RevFur/PurrEngine-hardware/Mechanical/Head_Transducer/Printable/Main_Body.stl

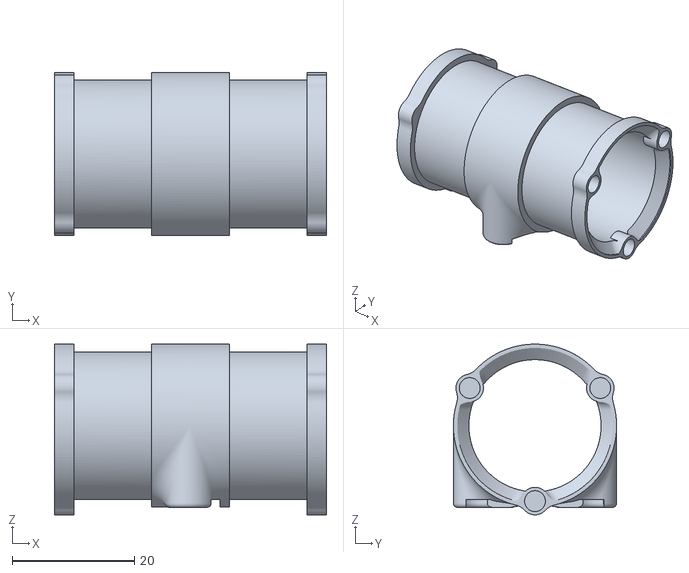
[picture p1: CAD file, 2018-11-15]
Mechanical/Head_Transducer/Printable/Main_Body.stl
44.5 x 26.7 x 27.9
