RevFur/PurrEngine-hardware/Mechanical/Chest_Transducer/Chest_Harness.step

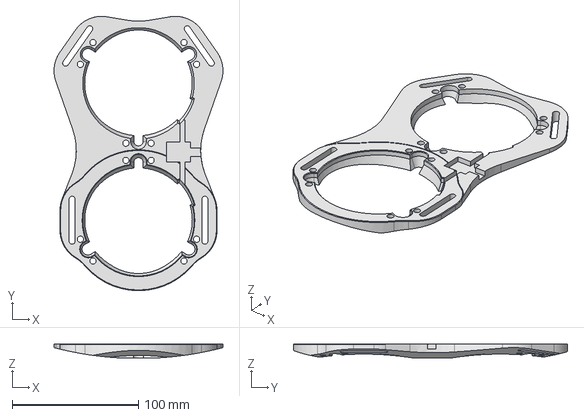
[picture p2: CAD file, 2018-11-15]
Mechanical/Chest_Transducer/Chest_Harness.step
134.1 x 217.6 x 11.2 mm
