RevFur/PurrEngine-hardware/Mechanical/Chest_Transducer/Dayton_Audio_Transducer.step

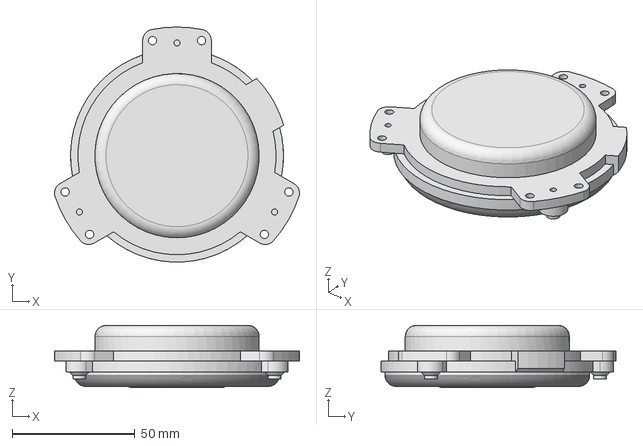
[picture p3: CAD file, 2018-11-15]
Mechanical/Chest_Transducer/Dayton_Audio_Transducer.step
100.0 x 95.9 x 25.4 mm
