RevFur/PurrEngine-hardware/Mechanical/Head_Transducer/Printable/Flexure.stl

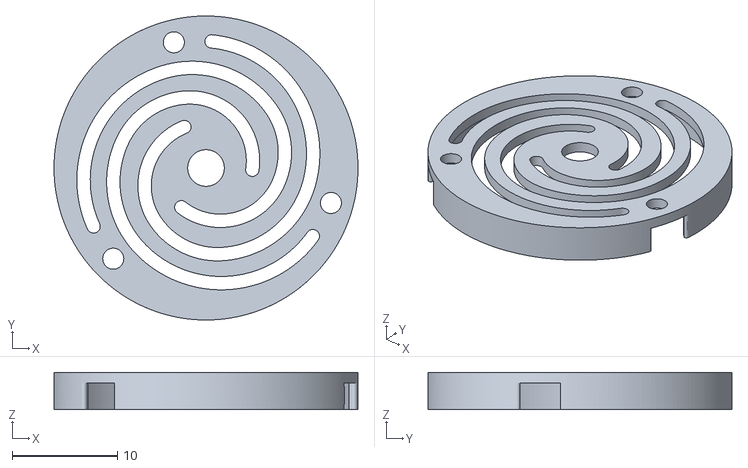
[picture p4: CAD file, 2018-11-15]
Mechanical/Head_Transducer/Printable/Flexure.stl
28.9 x 28.9 x 3.56
