RevFur/PurrEngine-hardware/Mechanical/Head_Transducer/Printable/Pin_Clip.stl

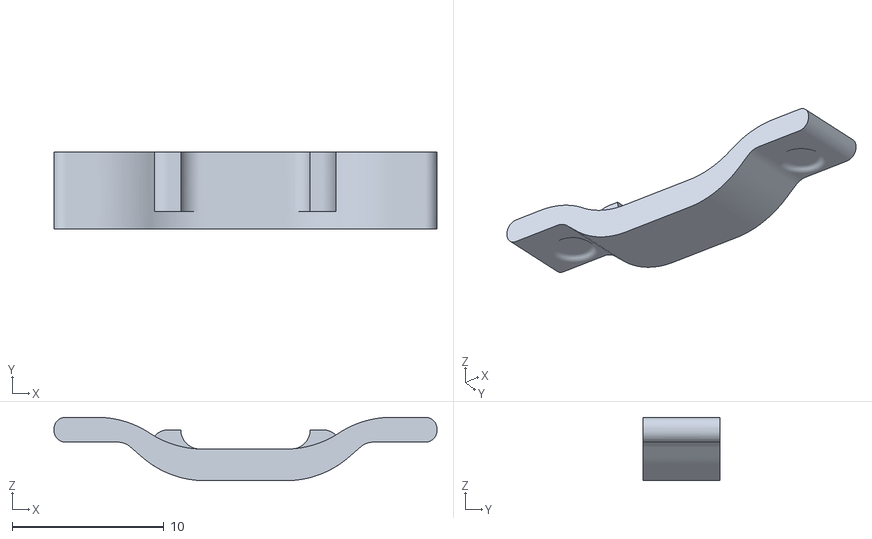
[picture p5: CAD file, 2018-11-15]
Mechanical/Head_Transducer/Printable/Pin_Clip.stl
25.2 x 5.08 x 4.18
