RevFur/PurrEngine-hardware/Mechanical/Head_Transducer/Printable/Spacer_0p125.stl

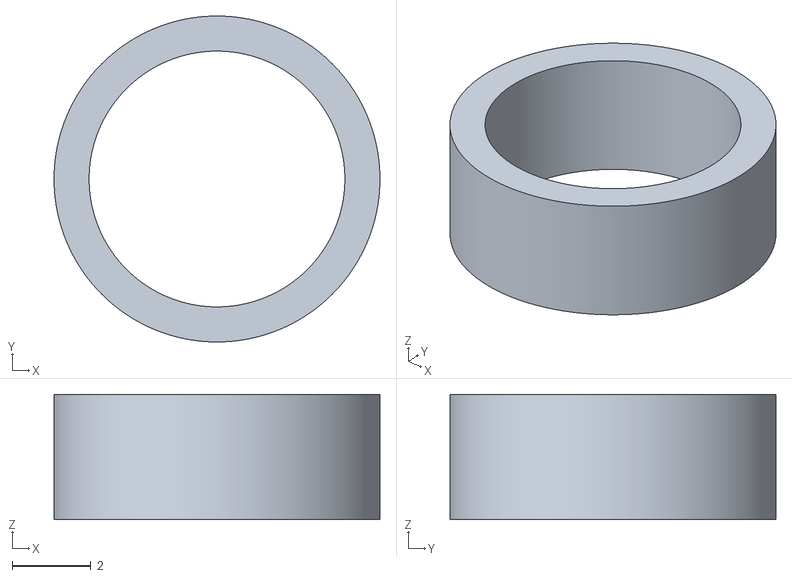
[picture p6: CAD file, 2018-11-15]
Mechanical/Head_Transducer/Printable/Spacer_0p125.stl
8.26 x 8.26 x 3.17
