RevFur/PurrEngine-hardware/Mechanical/Head_Transducer/Printable/Saddle.stl

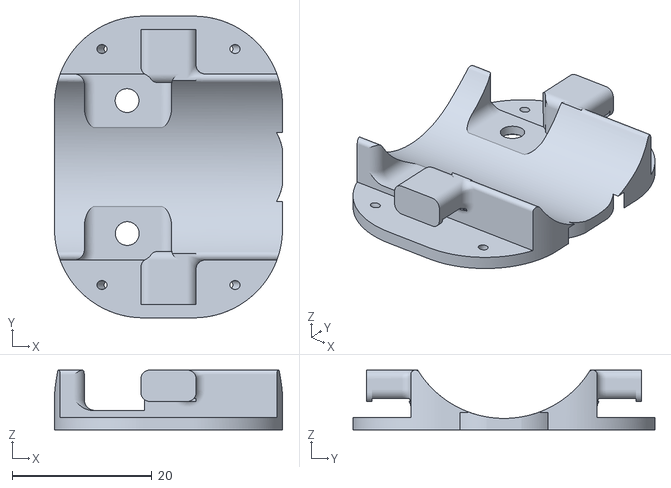
[picture p7: CAD file, 2018-11-15]
Mechanical/Head_Transducer/Printable/Saddle.stl
32.6 x 43.2 x 8.58
