RevFur/PurrEngine-hardware/(list of files, cad)

Other CAD files:
Mechanical/Chest_Transducer/Printable/Chest_Harness.stl
