RevFur/PurrEngine-hardware/PCB/Drawings/Purr_Amp.pdf

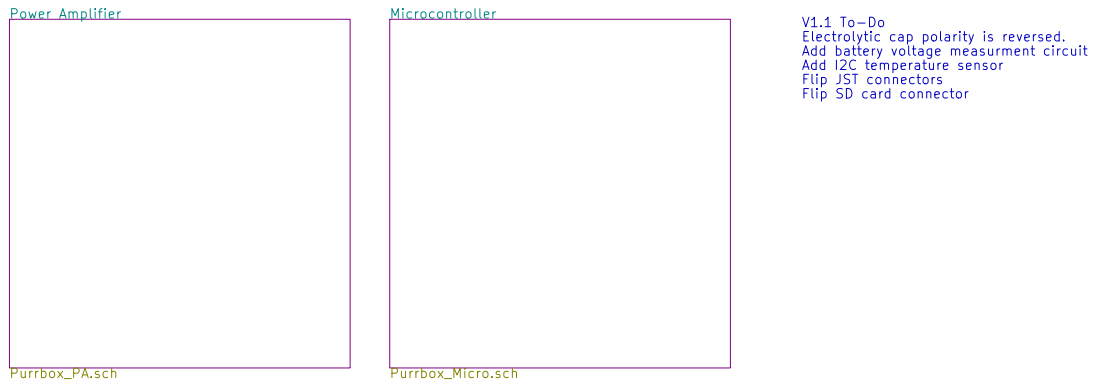
[picture p8: page 1]

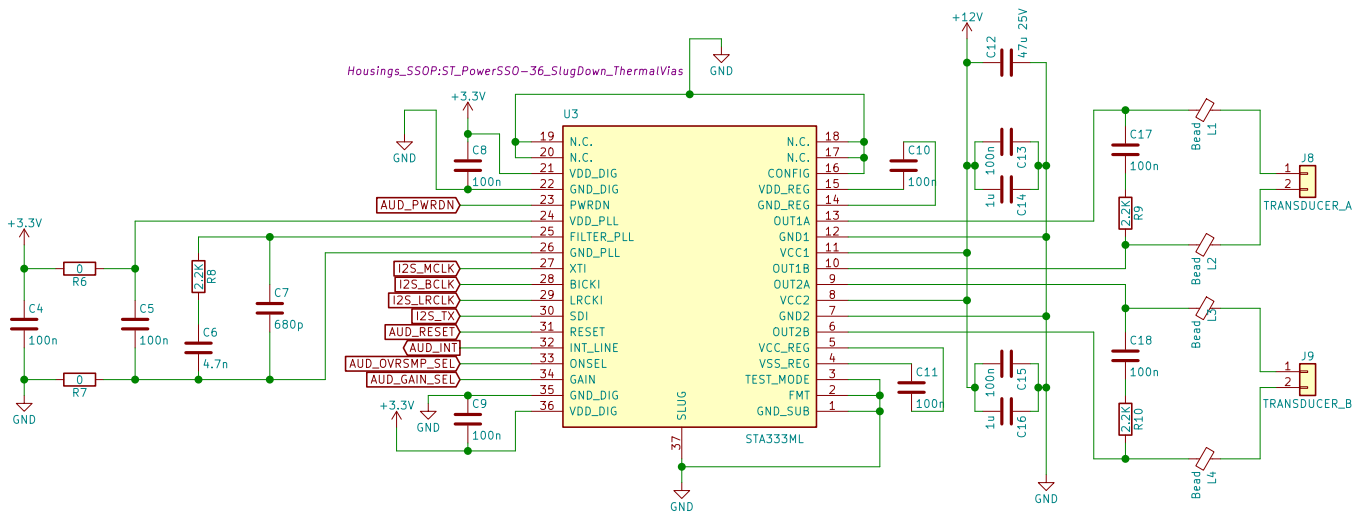
[picture p9: page 2]

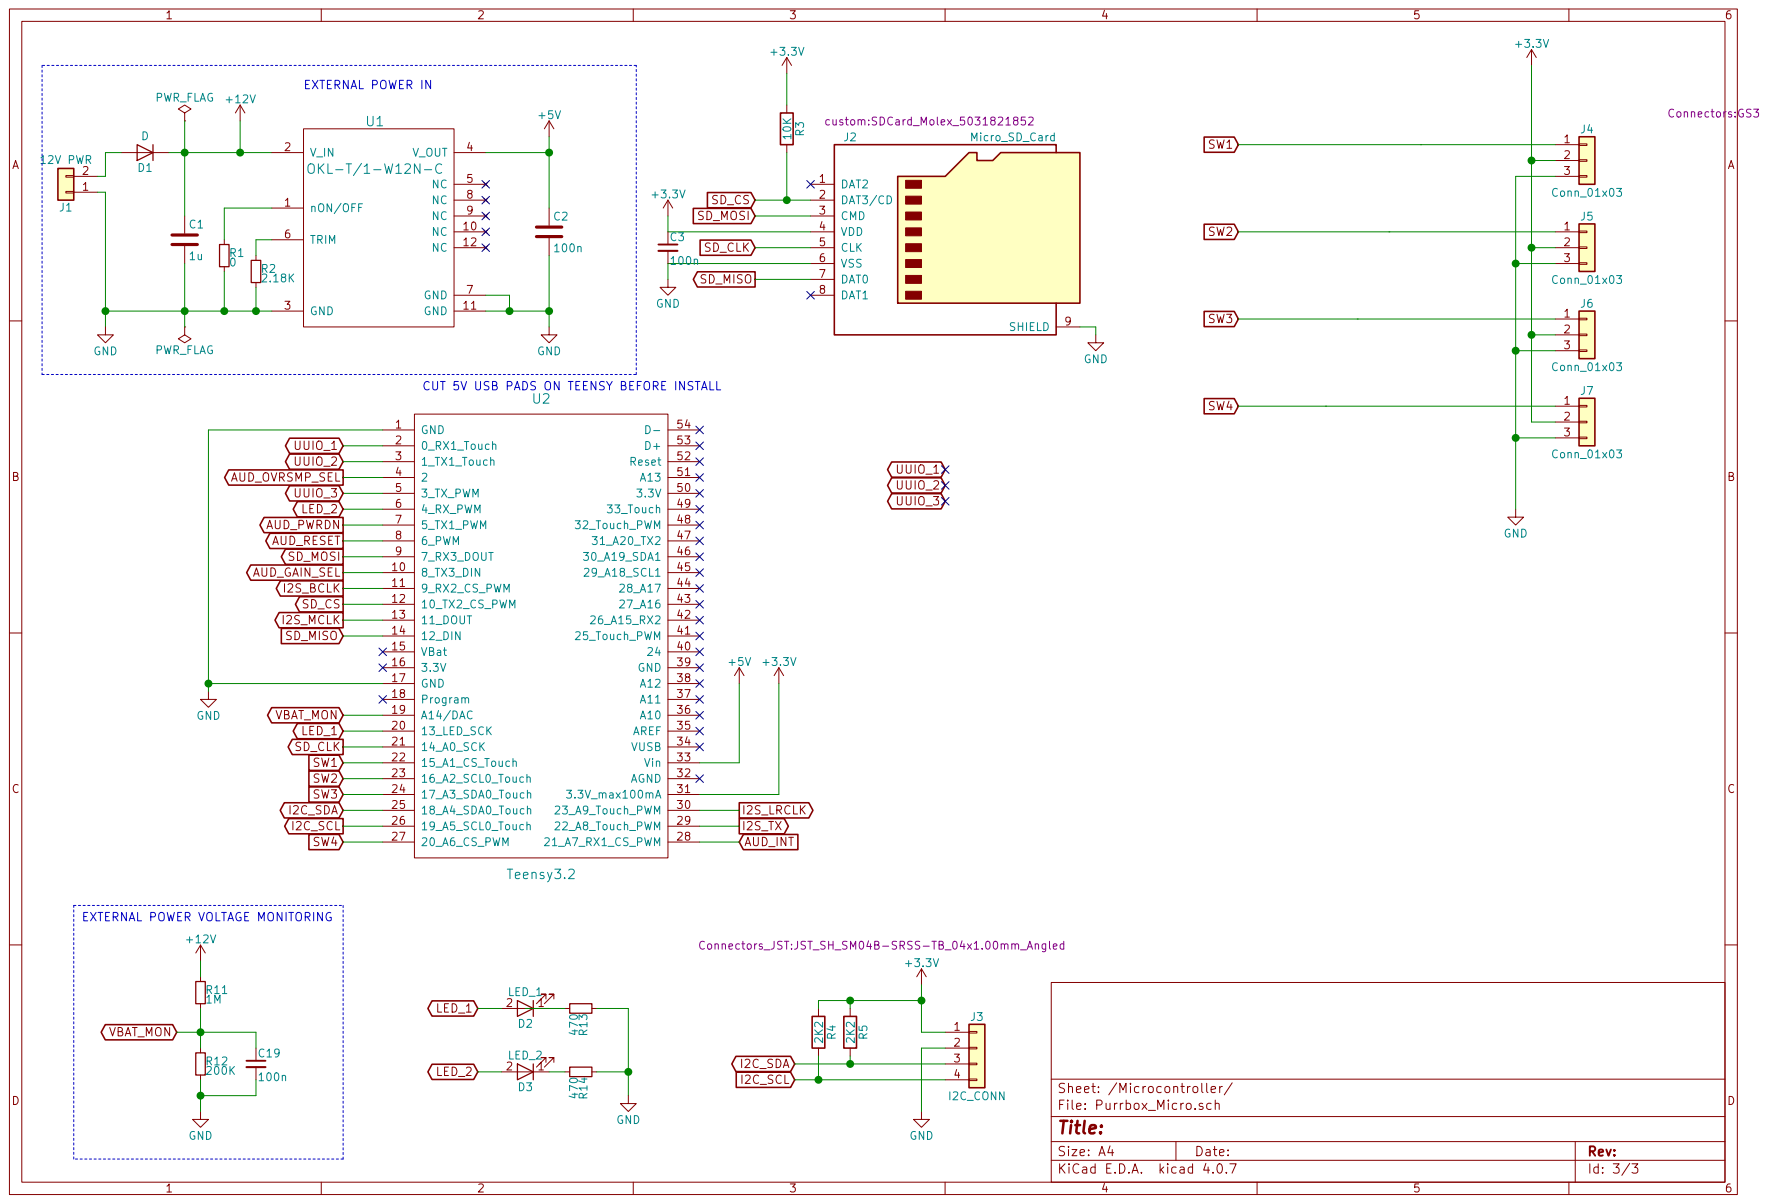
[picture p10: page 3]
