RevFur/PurrEngine-hardware/PCB/Purr_Amp.kicad_pcb

## KiCad design PCB/Purr_Amp.kicad_pcb (2018-11-15)

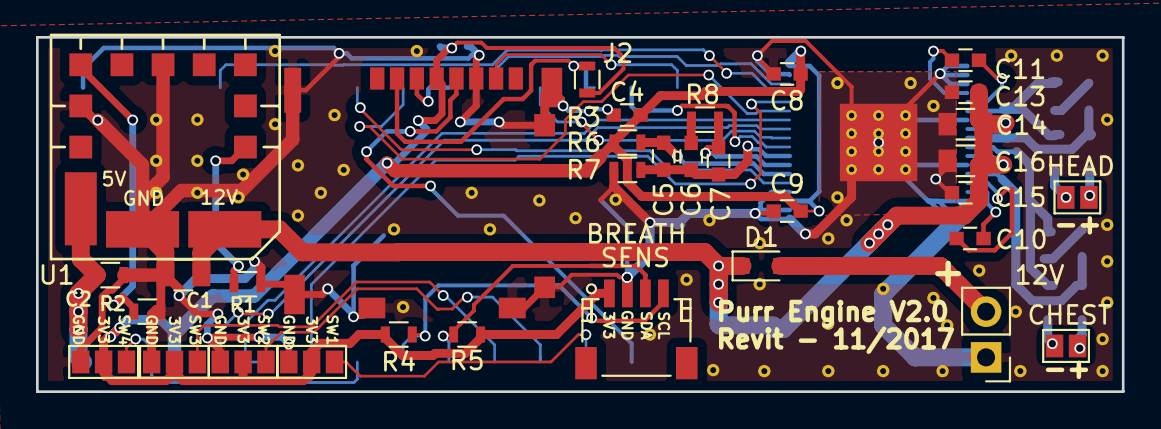
[picture p11: board Purr_Amp.kicad_pcb from above]

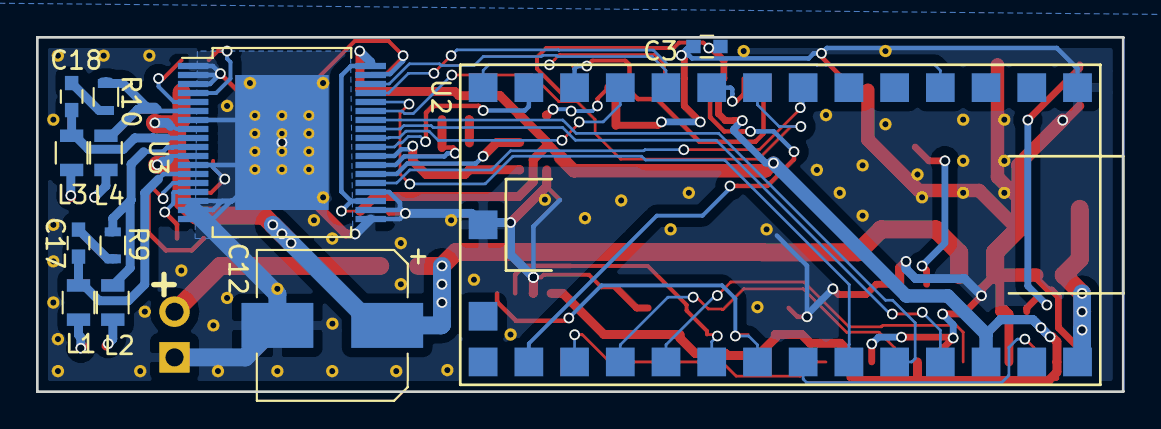
[picture p12: board Purr_Amp.kicad_pcb from below]

Board: 2 copper layers, 60.3 x 19.7 mm, 45 parts (12 on the bottom side), 44 nets.

Parts:
12V: 12V PWR; Pin_Header_Straight_1x02_Pitch2.54mm
BREATH: I2C_CONN; JST_SH_SM04B-SRSS-TB_04x1.00mm_Angled
C1: .33u; C_0805
C2: 100n; R_0603
C3, C4, C5, C8, C9, C10, C11, C13, C15, C17, C18: 100n; C_0603
C6: 4.7n; C_0603
C7: 680p; C_0603
C12: 47u 25V; CP_Elec_8x6.7
C14, C16: 1u; C_0805
CHEST: TRANSDUCER_A; GS2
D1: D; D_0805
HEAD: TRANSDUCER_B; GS2
J2: Micro_SD_Card; SDCard_Molex_5031821852
J4, J5, J6, J7: Conn_01x03; GS3
L1, L2, L3, L4: Bead; R_0805
R1, R6, R7: 0; R_0603
R2: 2.18K; R_0603
R3: 10K; R_0603
R4, R5: 2K2; R_0603
R8, R9, R10: 2.2K; R_0603
U1: OKL-T/1-W12N-C; MURATA_OKL1
U2: Teensy3.2; Teensy3.4_SMD
U3: STA333ML; ST_PowerSSO-36_SlugDown_ThermalVias

Connections:
+3V3: BREATH.1, C3.1, C4.1, C8.1, C9.2, J2.4, J4.2, J5.2, J6.2, J7.2, R3.1, R4.1, R5.1, R6.2, U2.31, U3.21, U3.36
+5V: C2.1, U1.4, U2.33
+12V: C1.1, C12.1, C13.2, C14.2, C15.2, C16.2, D1.1, U1.2, U3.8, U3.11
AUD_GAIN_SEL: U2.10, U3.34
AUD_INT: U2.28, U3.32
AUD_OVRSMP_SEL: U2.4, U3.33
AUD_PWRDN: U2.7, U3.23
AUD_RESET: U2.8, U3.31
GND: 12V.1, BREATH.2, C1.2, C2.2, C3.2, C4.2, C8.2, C9.1, C12.2, C13.1, C14.1, C15.1, C16.1, J2.6, J2.9, J4.3, J5.3, J6.3, J7.3, R1.2, R2.2, R7.2, U1.3, U1.7, U1.11, U2.1, U2.17, U3.1, U3.2, U3.3, U3.7, U3.12, U3.16, U3.17, U3.18, U3.19, U3.20, U3.22, U3.35, U3.37
I2C_SCL: BREATH.4, R4.2, U2.26
I2C_SDA: BREATH.3, R5.2, U2.25
I2S_BCLK: U2.11, U3.28
I2S_LRCLK: U2.30, U3.29
I2S_MCLK: U2.13, U3.27
I2S_TX: U2.29, U3.30
unnamed: C5.1, R6.1, U3.24
unnamed: C5.2, C6.2, C7.2, R7.1, U3.26
unnamed: C6.1, R8.2
unnamed: C7.1, R8.1, U3.25
unnamed: C10.1, U3.14
unnamed: C10.2, U3.15
unnamed: C11.1, U3.4
unnamed: C11.2, U3.5
unnamed: C17.1, L1.2, U3.13
unnamed: C17.2, R9.1
unnamed: C18.1, L3.2, U3.9
unnamed: C18.2, R10.1
unnamed: 12V.2, D1.2
unnamed: CHEST.1, L1.1
unnamed: CHEST.2, L2.1
unnamed: HEAD.1, L3.1
unnamed: HEAD.2, L4.1
unnamed: L2.2, R9.2, U3.10
unnamed: L4.2, R10.2, U3.6
unnamed: R1.1, U1.1
unnamed: R2.1, U1.6
SD_CLK: J2.5, U2.21
SD_CS: J2.2, R3.2, U2.12
SD_MISO: J2.7, U2.14
SD_MOSI: J2.3, U2.9
SW1: J4.1, U2.22
SW2: J5.1, U2.23
SW3: J6.1, U2.24
SW4: J7.1, U2.27
