RevFur/PurrEngine-hardware/(commit log)

2018-11-15 Initial commit of hardware components
    [Chest_Harness.step, Chest_Harness.stl, Chest_Transducer_BOM.csv, Dayton_Audio_Transducer.step, Flexure.stl, Head_Transducer_BOM.csv, Main_Body.stl, Pin_Clip.stl]
2018-11-15 Added .pdf version of Purr_Amp schematic
